modt25/WortWorm/README.md

# WortWorm
Tilt Hydrometer for Atto-Brewing
