modt25/WortWorm/WortWorm_Battery.FCStd

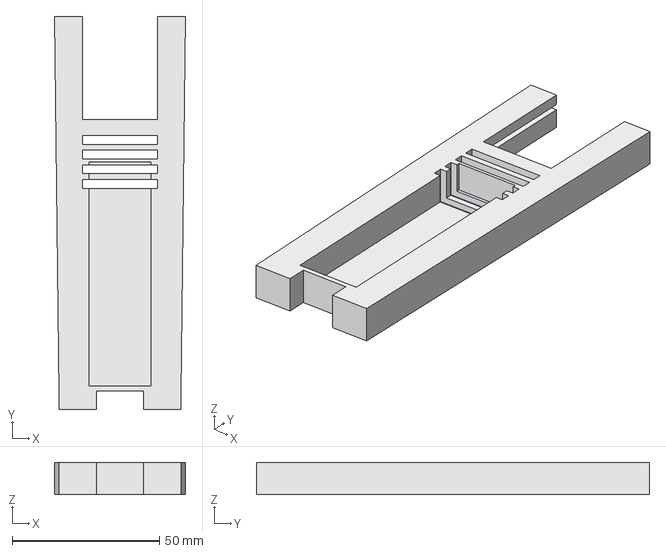
[picture p5: CAD file, 2018-10-26]
WortWorm_Battery.FCStd
44.5 x 133.3 x 11.0 mm
